cinnamon-bun/thumble/reference/feather-photo.png

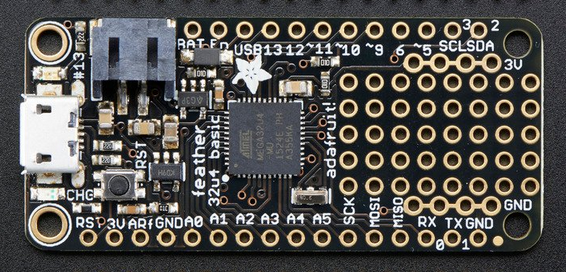
reference/feather-photo.png
