cinnamon-bun/thumble/reference/feather_dimensions.png

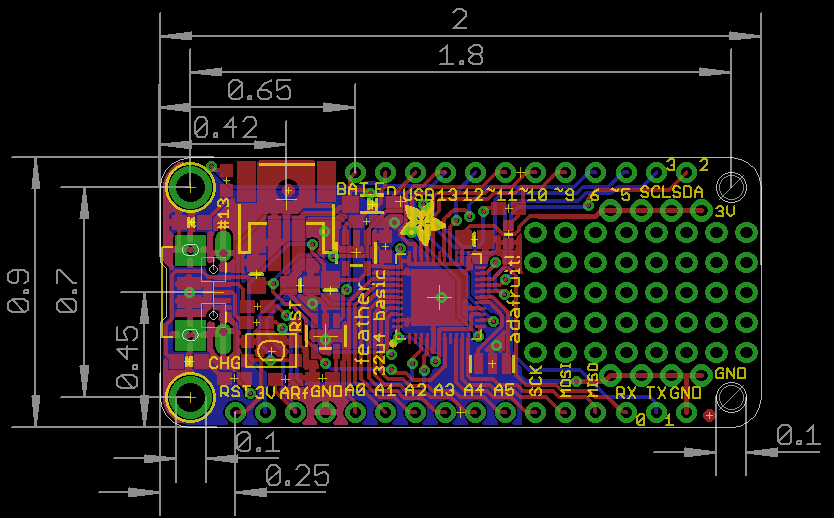
reference/feather_dimensions.png
