cinnamon-bun/thumble/reference/feather_pinout_Adafruit_Feather_32u4_Basic_Proto_v2.3-1.png

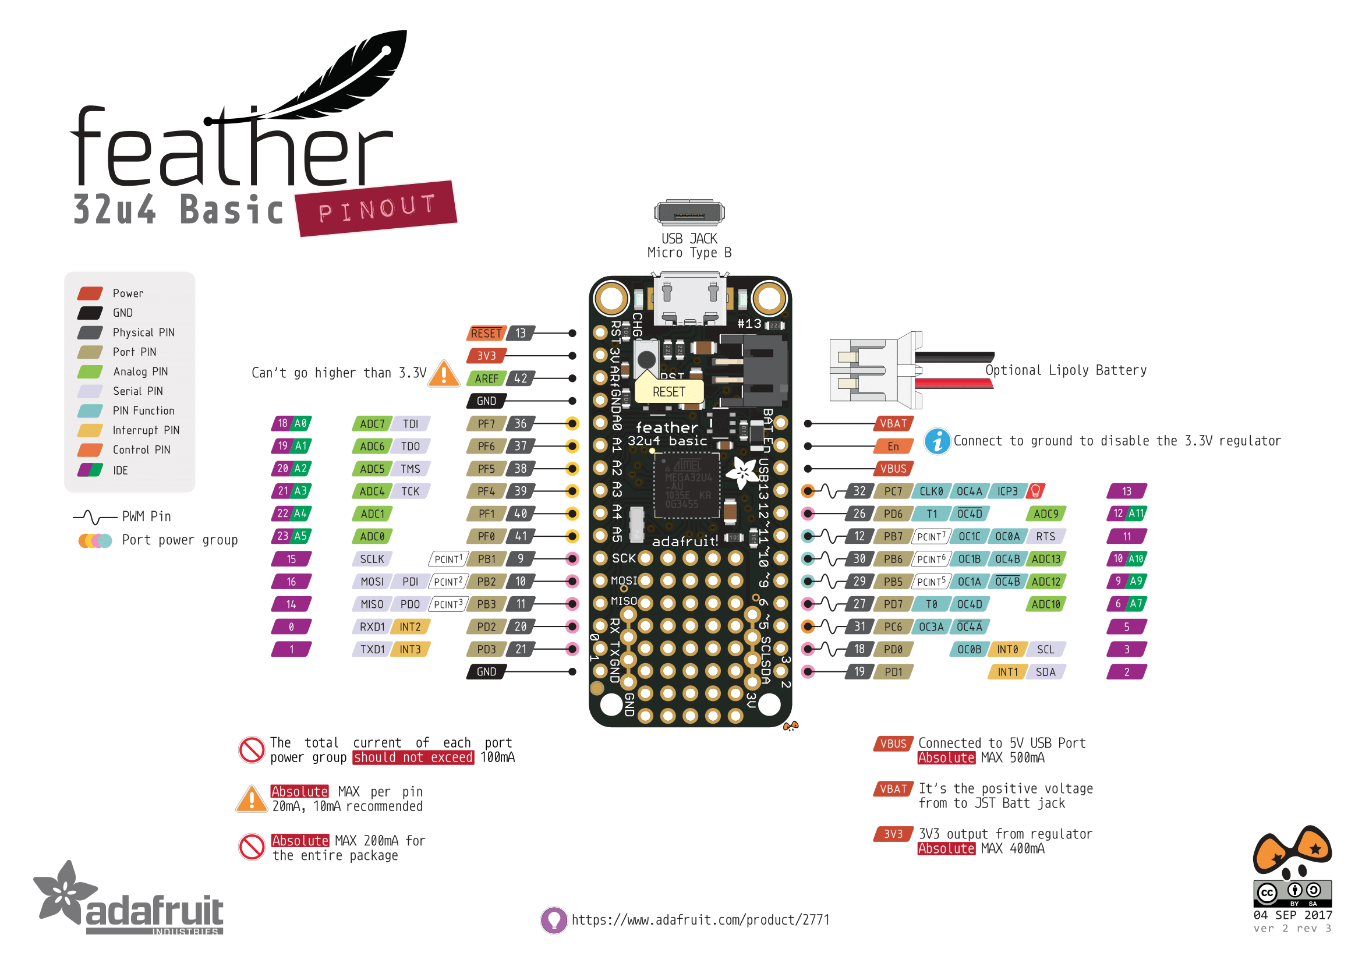
reference/feather_pinout_Adafruit_Feather_32u4_Basic_Proto_v2.3-1.png
