cinnamon-bun/thumble/reference/joystick circuit.png

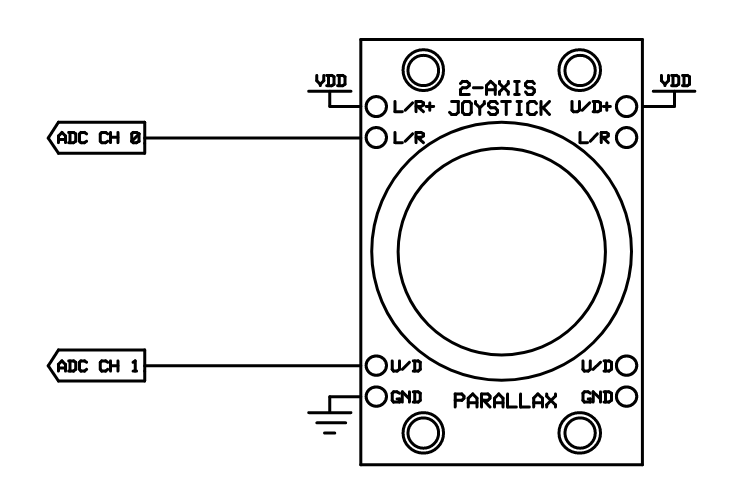
reference/joystick circuit.png
