cinnamon-bun/thumble/reference/joystick dimensions 2.png

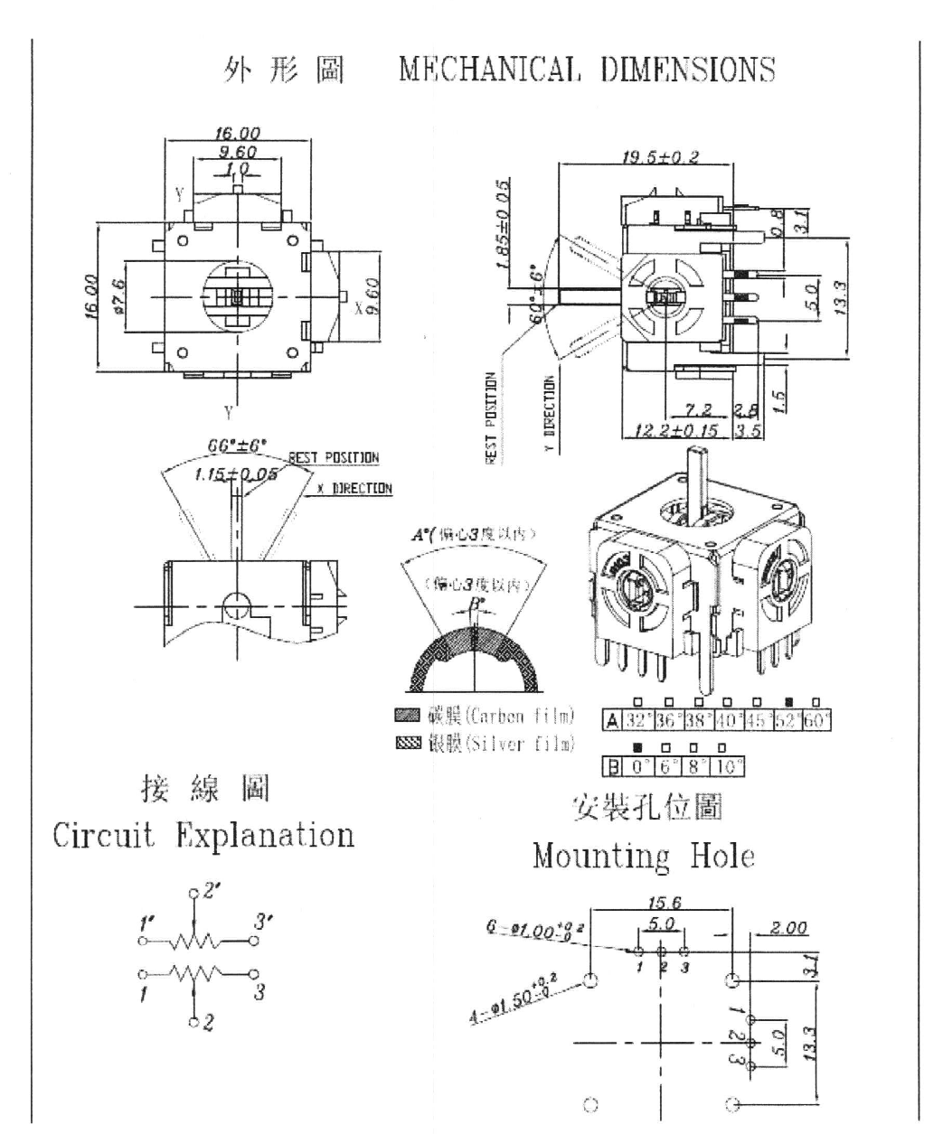
reference/joystick dimensions 2.png
