cinnamon-bun/thumble/reference/joystick dimensions.png

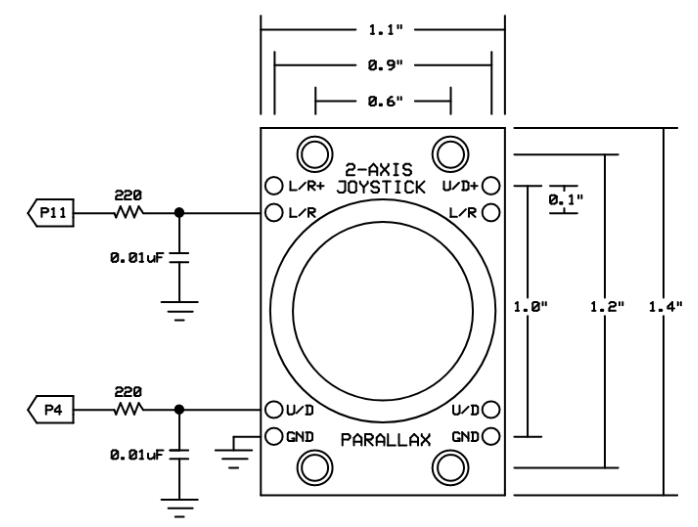
reference/joystick dimensions.png
