cinnamon-bun/thumble/reference/joystick-PCB-back.png

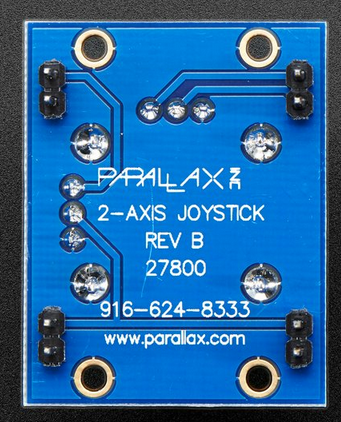
reference/joystick-PCB-back.png
