cinnamon-bun/thumble/reference/xbox-controller.png

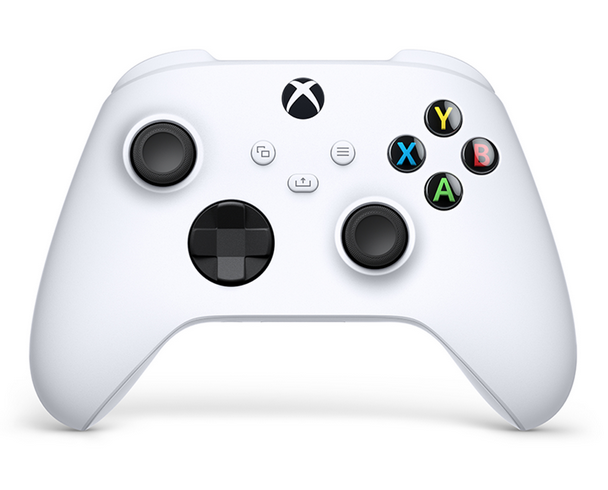
reference/xbox-controller.png
