cinnamon-bun/thumble/reference/xbox-dimensions.png

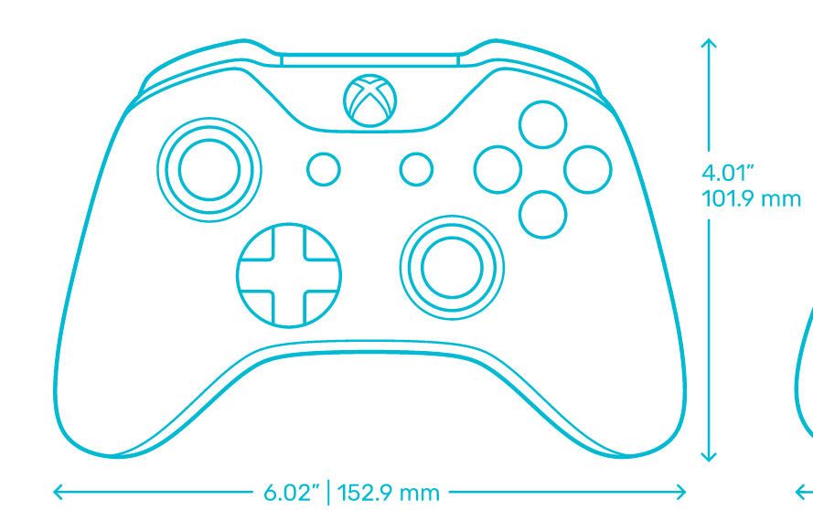
reference/xbox-dimensions.png
