cinnamon-bun/thumble/build_photos/PXL_20210628_162610314.jpg

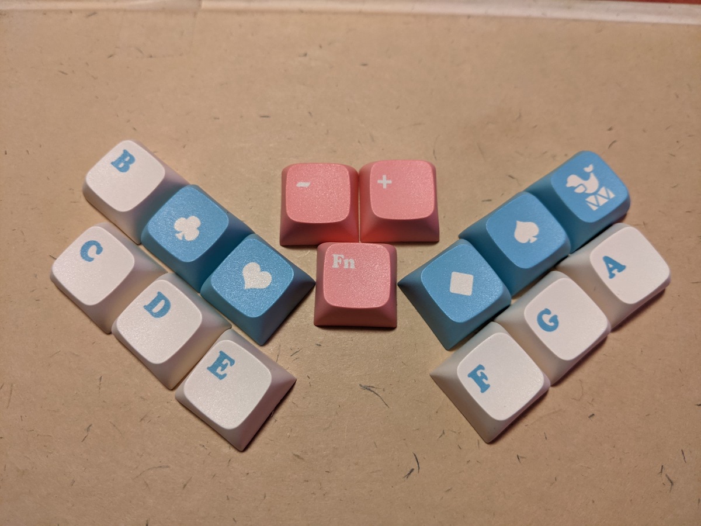
build_photos/PXL_20210628_162610314.jpg
