cinnamon-bun/thumble/build_photos/PXL_20210628_162711512.jpg

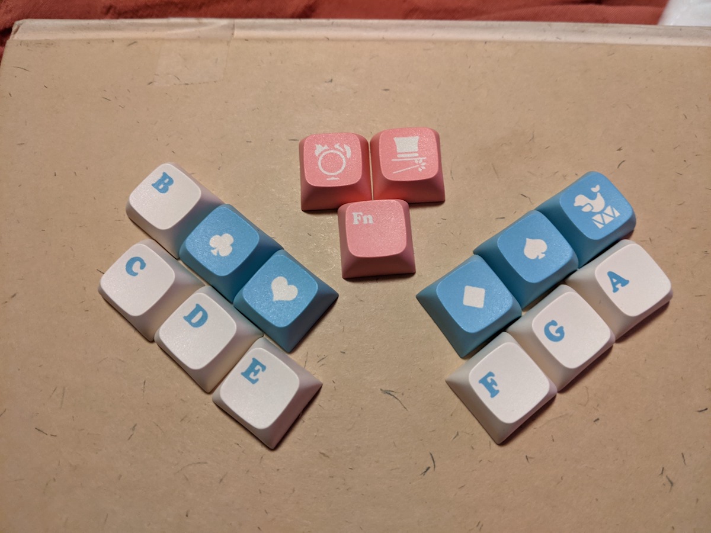
build_photos/PXL_20210628_162711512.jpg
