cinnamon-bun/thumble/(commit log)

2021-06-25 add case; update README
2021-06-26 update case
2021-06-28 add wiring diagram
2021-07-04 Fixed pullup on switch pins
    [thumble_001_arduino.ino]
2021-07-04 Fixed cooldown locking notes on
    [thumble_001_arduino.ino]
2021-07-07 fix two keys out of order
    [thumble_001_arduino.ino]
2021-07-07 improve latency by shortening key cooldown. probably the cooldown is being applied at the leading edge instead of the trailing edge...
    [thumble_001_arduino.ino]
2021-07-09 Fix power draw on iOS devices
    [thumble_001_arduino.ino]
2021-07-09 add note about ground wire in diagram
2021-07-10 Add notes on bluetooth wireless MIDI
2021-11-24 fix backwards shepard tones; they work now
    [thumble_001_arduino.ino]
